svpetry/12VSupport/README.md

# 12VSupport
System to support a vehicle 12V electrical system with a LiIon battery to prevent the lead battery from depletion.
