svpetry/12VSupport/Board/12VSupport.kicad_pcb

## KiCad design Board/12VSupport.kicad_pcb (2026-06-07)

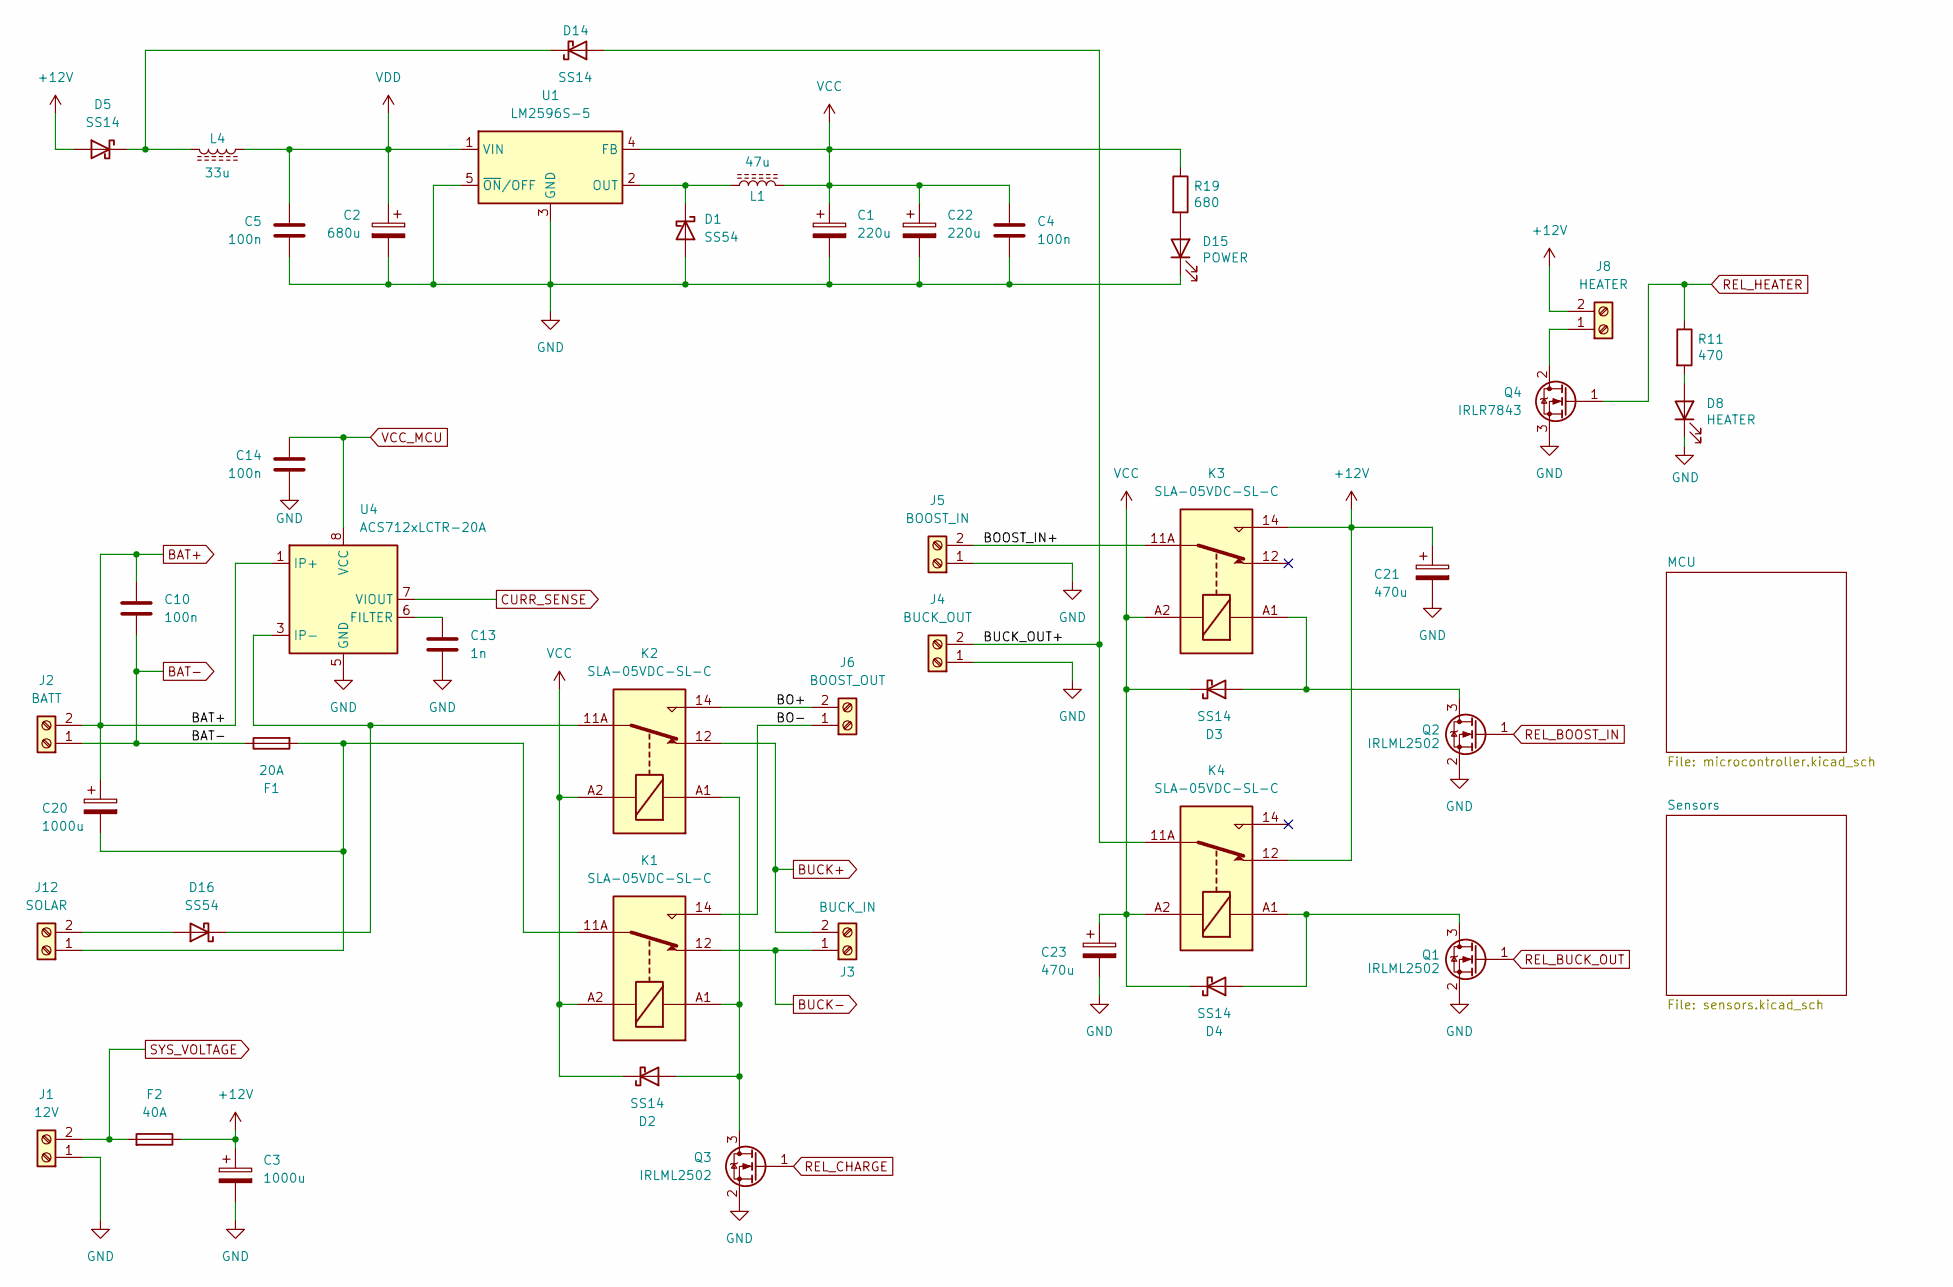
[picture p1: schematic 12VSupport.kicad_sch]

Parts:
C1, C22: 220u; CP_Radial_D6.3mm_P2.50mm
C2: 680u; CP_Radial_D10.0mm_P5.00mm
C3, C20: 1000u; CP_Radial_D13.0mm_P5.00mm
C4, C5, C10, C14: 100n; C_0805_2012Metric
C13: 1n; C_0805_2012Metric
C21: 470u; CP_Radial_D10.0mm_P5.00mm
C23: 470u; CP_Radial_D8.0mm_P3.80mm
D1, D16: SS54; D_SMB
D2, D3, D4, D5, D14: SS14; D_SMA
D8: HEATER; LED_0805_2012Metric
D15: POWER; LED_0805_2012Metric
F1: 20A; Fuseholder_Blade
F2: 40A; Fuseholder_Blade
J1: 12V; KF7.62_2P
J2: BATT; KF7.62_2P
J3: BUCK_IN; KF7.62_2P
J4: BUCK_OUT; KF7.62_2P
J5: BOOST_IN; KF7.62_2P
J6: BOOST_OUT; KF7.62_2P
J8: HEATER; TerminalBlock_Altech_AK300-2_P5.00mm
J12: SOLAR; TerminalBlock_Altech_AK300-2_P5.00mm
K1, K2, K3, K4: SLA-05VDC-SL-C; Relay_SPDT_RAYEX-L90
L1: 47u; L_12x12mm_H6mm
L4: 33u; L_10.4x10.4_H4.8
Q1, Q2, Q3: IRLML2502; SOT-23
Q4: IRLR7843; TO-252-2
R11: 470; R_0805_2012Metric
R19: 680; R_0805_2012Metric
U1: LM2596S-5; TO-263-5_TabPin3
U4: ACS712xLCTR-20A; SOIC-8_3.9x4.9mm_P1.27mm

Connections:
+12V: C3.1, C21.1, D5.2 (A), F2.1, J8.2, K3.14, K4.12
/BO+: J6.2, K2.14
/BO-: J6.1, K1.14
/BOOST_IN+: J5.2, K3.11A, K3.11B
/BUCK_OUT+: D14.2 (A), J4.2, K4.11A, K4.11B
BAT+: C10.1, C20.1, J2.2, U4.1 (IP+), U4.2 (IP+); also elsewhere on the board
BAT-: C10.2, F1.1, J2.1; also elsewhere on the board
BUCK+: J3.2, K2.12
BUCK-: J3.1, K1.12
CURR_SENSE: U4.7 (VIOUT); also elsewhere on the board
GND: C1.2, C2.2, C3.2, C4.2, C5.2, C13.2, C14.2, C21.2, C22.2, C23.2, D1.2 (A), D8.1 (K), D15.1 (K), J1.1, J4.1, J5.1, Q1.2 (S), Q2.2 (S), Q3.2 (S), Q4.3 (S), U1.3 (GND), U1.5 (~ON/OFF), U4.5 (GND); also elsewhere on the board
unnamed: D1.1 (K), L1.1, U1.2 (OUT)
unnamed: D2.2 (A), K1.A1, K2.A1, Q3.3 (D)
unnamed: D3.2 (A), K3.A1, Q2.3 (D)
unnamed: D4.2 (A), K4.A1, Q1.3 (D)
unnamed: D8.2 (A), R11.2
unnamed: D5.1 (K), D14.1 (K), L4.2
unnamed: D15.2 (A), R19.2
unnamed: D16.2 (A), J12.2
unnamed: D16.1 (K), K2.11A, K2.11B, U4.3 (IP-), U4.4 (IP-)
unnamed: J8.1, Q4.2 (D)
unnamed: C20.2, F1.2, J12.1, K1.11A, K1.11B
unnamed: C13.1, U4.6 (FILTER)
REL_BOOST_IN: Q2.1 (G); also elsewhere on the board
REL_BUCK_OUT: Q1.1 (G); also elsewhere on the board
REL_CHARGE: Q3.1 (G); also elsewhere on the board
REL_HEATER: Q4.1 (G), R11.1; also elsewhere on the board
SYS_VOLTAGE: F2.2, J1.2; also elsewhere on the board
VCC: C1.1, C4.1, C22.1, C23.1, D2.1 (K), D3.1 (K), D4.1 (K), K1.A2, K2.A2, K3.A2, K4.A2, L1.2, R19.1, U1.4 (FB); also elsewhere on the board
VCC_MCU: C14.1, U4.8 (VCC); also elsewhere on the board
VDD: C2.1, C5.1, L4.1, U1.1 (VIN); also elsewhere on the board

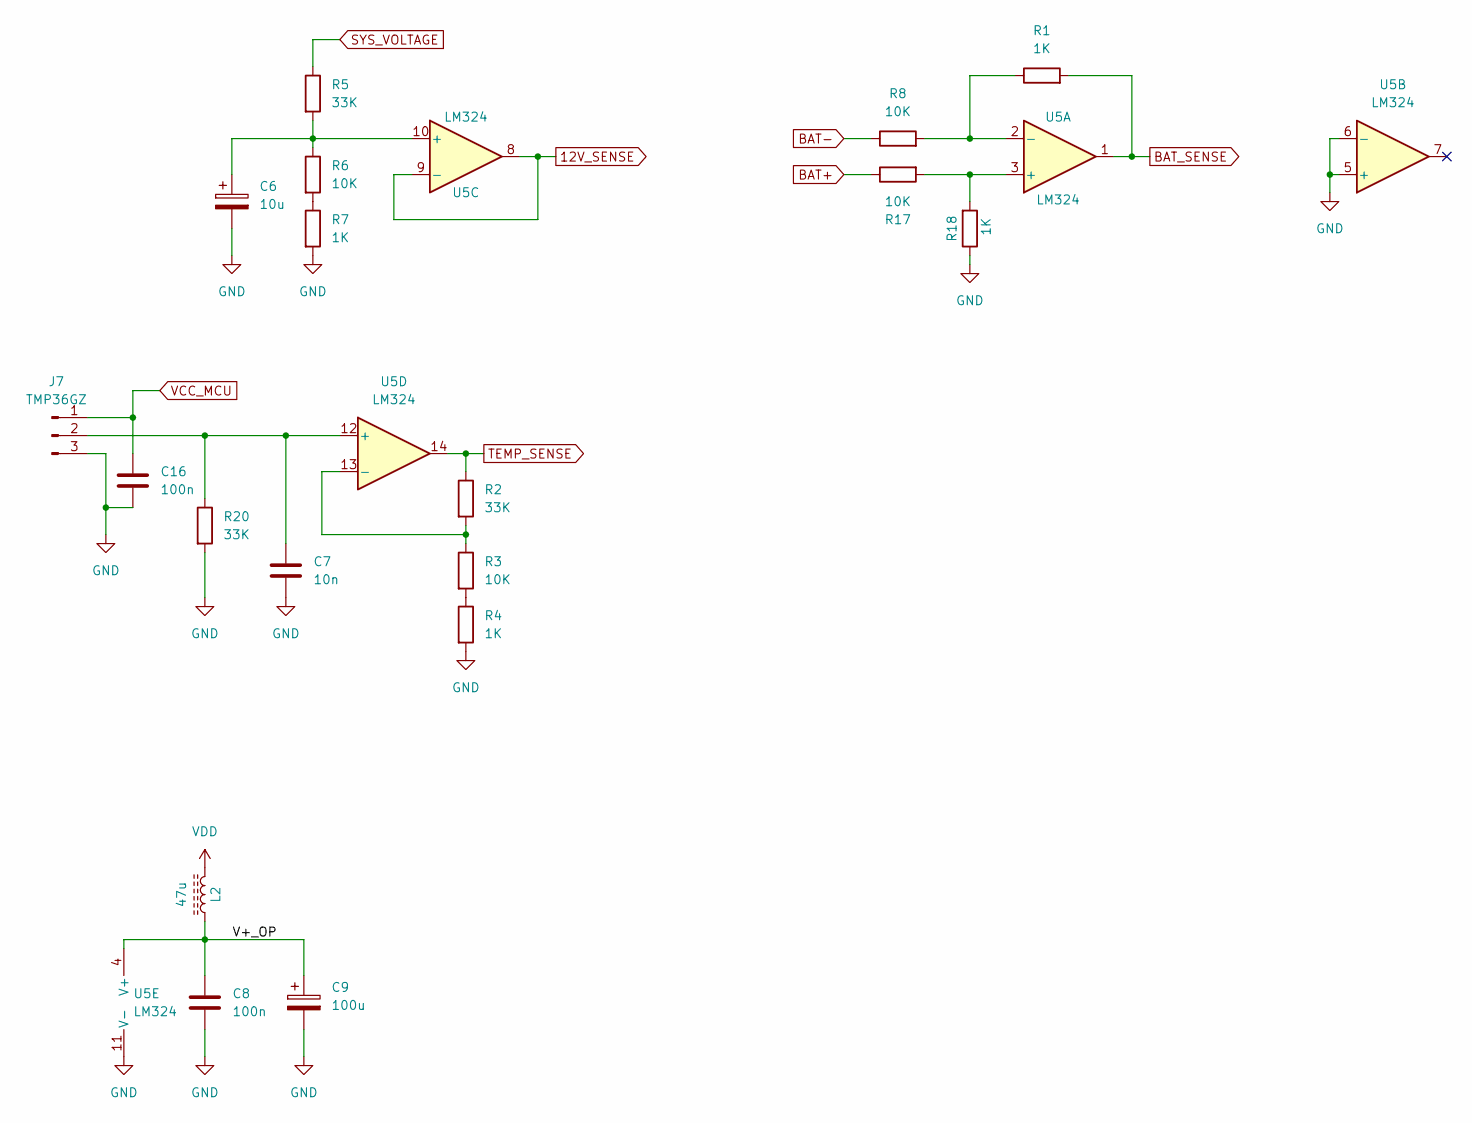
[picture p2: schematic sensors.kicad_sch]

Parts:
C6: 10u; C_1206_3216Metric_Pad1.33x1.80mm_HandSolder
C7: 10n; C_0805_2012Metric
C8, C16: 100n; C_0805_2012Metric
C9: 100u; CP_Radial_D5.0mm_P2.50mm
J7: TMP36GZ; JST_PH_B3B-PH-K_1x03_P2.00mm_Vertical
L2: 47u; L_10.4x10.4_H4.8
R1, R4, R7, R18: 1K; R_0805_2012Metric
R2, R5, R20: 33K; R_0805_2012Metric
R3, R6, R8, R17: 10K; R_0805_2012Metric
U5: LM324; SOIC-14_3.9x8.7mm_P1.27mm

Connections:
12V_SENSE: U5.8, U5.9 (-); also elsewhere on the board
/Sensors/V+_OP: C8.1, C9.1, L2.1, U5.4 (V+)
BAT+: R17.1; also elsewhere on the board
BAT-: R8.1; also elsewhere on the board
BAT_SENSE: R1.2, U5.1; also elsewhere on the board
GND: C6.2, C7.2, C8.2, C9.2, C16.2, J7.3, R4.2, R7.2, R18.1, R20.2, U5.5 (+), U5.6 (-), U5.11 (V-); also elsewhere on the board
unnamed: C7.1, J7.2, R20.1, U5.12 (+)
unnamed: R3.2, R4.1
unnamed: R6.2, R7.1
unnamed: R17.2, R18.2, U5.3 (+)
unnamed: R1.1, R8.2, U5.2 (-)
unnamed: C6.1, R5.2, R6.1, U5.10 (+)
unnamed: R2.2, R3.1, U5.13 (-)
SYS_VOLTAGE: R5.1; also elsewhere on the board
TEMP_SENSE: R2.1, U5.14; also elsewhere on the board
VCC_MCU: C16.1, J7.1; also elsewhere on the board
VDD: L2.2; also elsewhere on the board

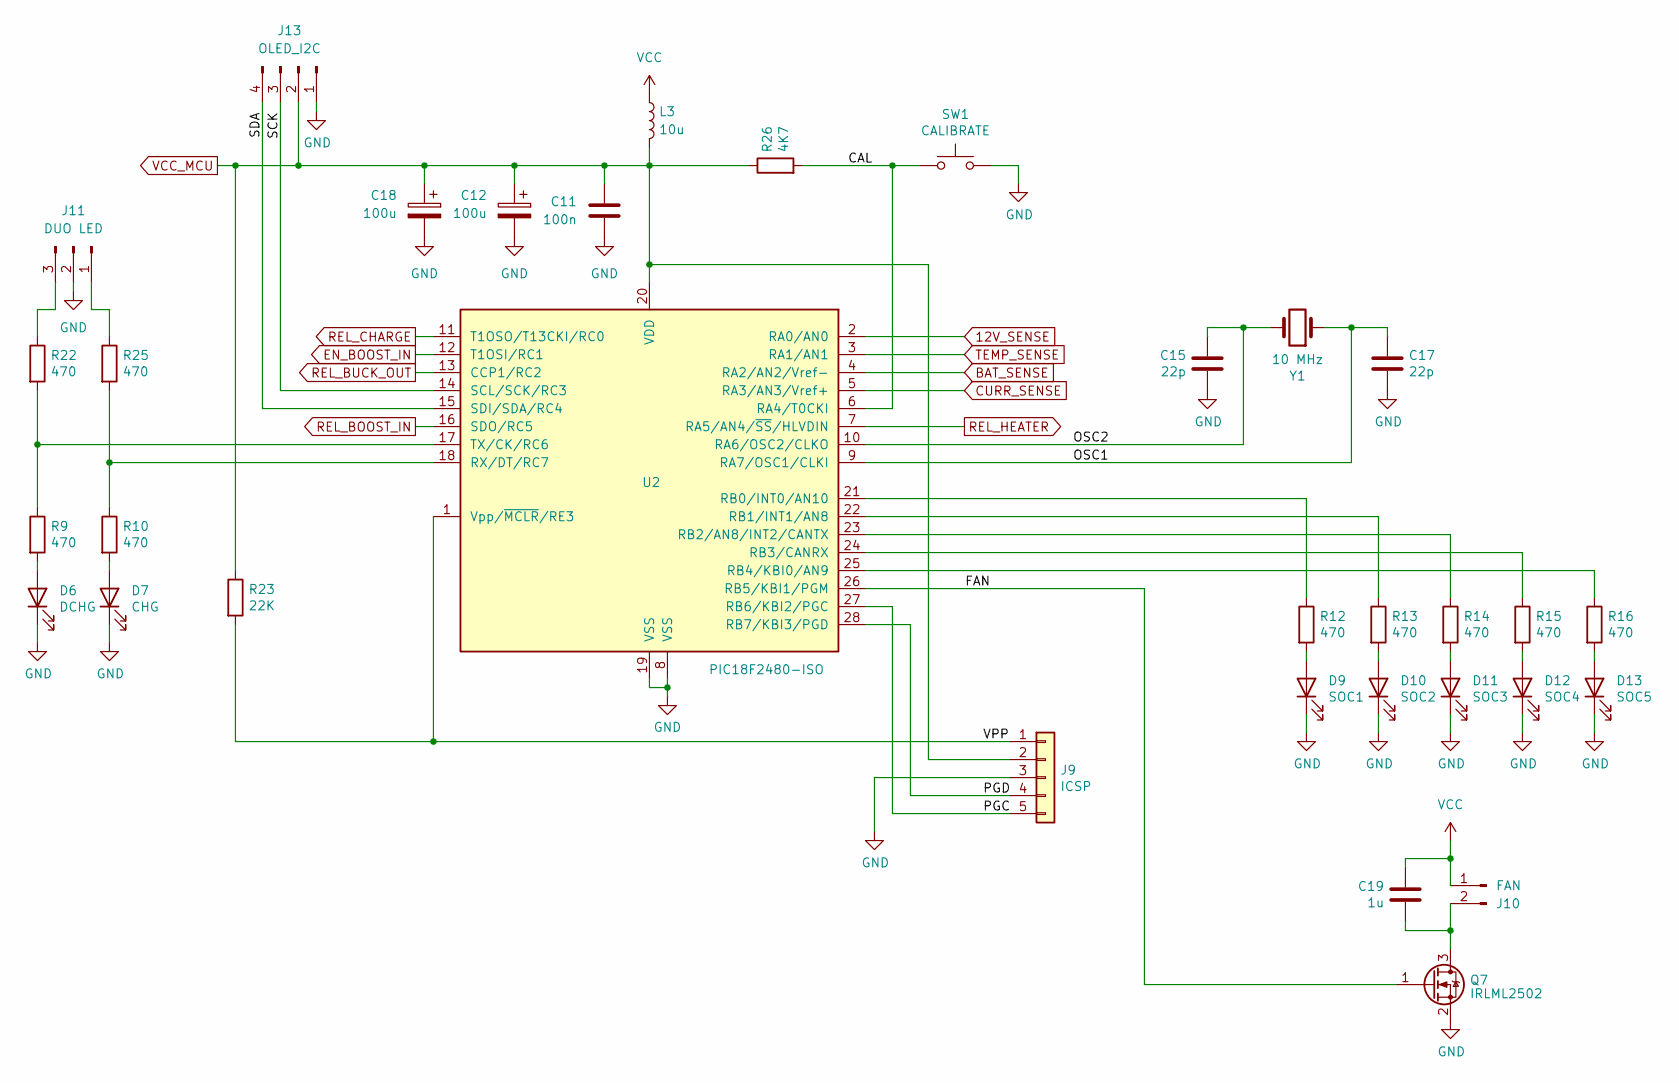
[picture p3: schematic microcontroller.kicad_sch]

Parts:
C11: 100n; C_0805_2012Metric
C12, C18: 100u; CP_Radial_D5.0mm_P2.50mm
C15, C17: 22p; C_0805_2012Metric
C19: 1u; C_1206_3216Metric
D6: DCHG; LED_0805_2012Metric
D7: CHG; LED_0805_2012Metric
D9: SOC1; LED_0805_2012Metric
D10: SOC2; LED_0805_2012Metric
D11: SOC3; LED_0805_2012Metric
D12: SOC4; LED_0805_2012Metric
D13: SOC5; LED_0805_2012Metric
J9: ICSP; PinHeader_1x05_P2.54mm_Vertical
J10: FAN; JST_XH_B2B-XH-A_1x02_P2.50mm_Vertical
J11: DUO LED; JST_PH_B3B-PH-K_1x03_P2.00mm_Vertical
J13: OLED_I2C; JST_PH_B4B-PH-K_1x04_P2.00mm_Vertical
L3: 10u; CD43
Q7: IRLML2502; SOT-23
R9, R10, R12, R13, R14, R15, R16, R22, R25: 470; R_0805_2012Metric
R23: 22K; R_0805_2012Metric
R26: 4K7; R_0805_2012Metric
SW1: CALIBRATE; SW_SPST_CK_RS282G05A3
U2: PIC18F2480-ISO; SOIC-28W_7.5x17.9mm_P1.27mm
Y1: 10 MHz; Crystal_HC18-U_Vertical

Connections:
12V_SENSE: U2.2 (RA0/AN0); also elsewhere on the board
/MCU/CAL: R26.2, SW1.1, U2.6 (RA4/T0CKI)
/MCU/FAN: Q7.1 (G), U2.26 (RB5/KBI1/PGM)
/MCU/OSC1: C17.1, U2.9 (RA7/OSC1/CLKI), Y1.1
/MCU/OSC2: C15.1, U2.10 (RA6/OSC2/CLKO), Y1.2
/MCU/PGC: J9.5, U2.27 (RB6/KBI2/PGC)
/MCU/PGD: J9.4, U2.28 (RB7/KBI3/PGD)
/MCU/SCK: J13.3, U2.14 (SCL/SCK/RC3)
/MCU/SDA: J13.4, U2.15 (SDI/SDA/RC4)
/MCU/VPP: J9.1, R23.2, U2.1 (Vpp/~MCLR/RE3)
BAT_SENSE: U2.4 (RA2/AN2/Vref-); also elsewhere on the board
CURR_SENSE: U2.5 (RA3/AN3/Vref+); also elsewhere on the board
EN_BOOST_IN: U2.12 (T1OSI/RC1)
GND: C11.2, C12.2, C15.2, C17.2, C18.2, D6.1 (K), D7.1 (K), D9.1 (K), D10.1 (K), D11.1 (K), D12.1 (K), D13.1 (K), J9.3, J11.2, J13.1, Q7.2 (S), SW1.2, U2.8 (VSS), U2.19 (VSS); also elsewhere on the board
unnamed: D6.2 (A), R9.2
unnamed: D7.2 (A), R10.2
unnamed: D9.2 (A), R12.2
unnamed: D10.2 (A), R13.2
unnamed: D11.2 (A), R14.2
unnamed: D12.2 (A), R15.2
unnamed: D13.2 (A), R16.2
unnamed: C19.2, J10.2, Q7.3 (D)
unnamed: J11.1, R25.1
unnamed: J11.3, R22.1
unnamed: R12.1, U2.21 (RB0/INT0/AN10)
unnamed: R13.1, U2.22 (RB1/INT1/AN8)
unnamed: R14.1, U2.23 (RB2/AN8/INT2/CANTX)
unnamed: R15.1, U2.24 (RB3/CANRX)
unnamed: R16.1, U2.25 (RB4/KBI0/AN9)
unnamed: R10.1, R25.2, U2.18 (RX/DT/RC7)
unnamed: R9.1, R22.2, U2.17 (TX/CK/RC6)
REL_BOOST_IN: U2.16 (SDO/RC5); also elsewhere on the board
REL_BUCK_OUT: U2.13 (CCP1/RC2); also elsewhere on the board
REL_CHARGE: U2.11 (T1OSO/T13CKI/RC0); also elsewhere on the board
REL_HEATER: U2.7 (RA5/AN4/~SS/HLVDIN); also elsewhere on the board
TEMP_SENSE: U2.3 (RA1/AN1); also elsewhere on the board
VCC: C19.1, J10.1, L3.1; also elsewhere on the board
VCC_MCU: C11.1, C12.1, C18.1, J9.2, J13.2, L3.2, R23.1, R26.1, U2.20 (VDD); also elsewhere on the board

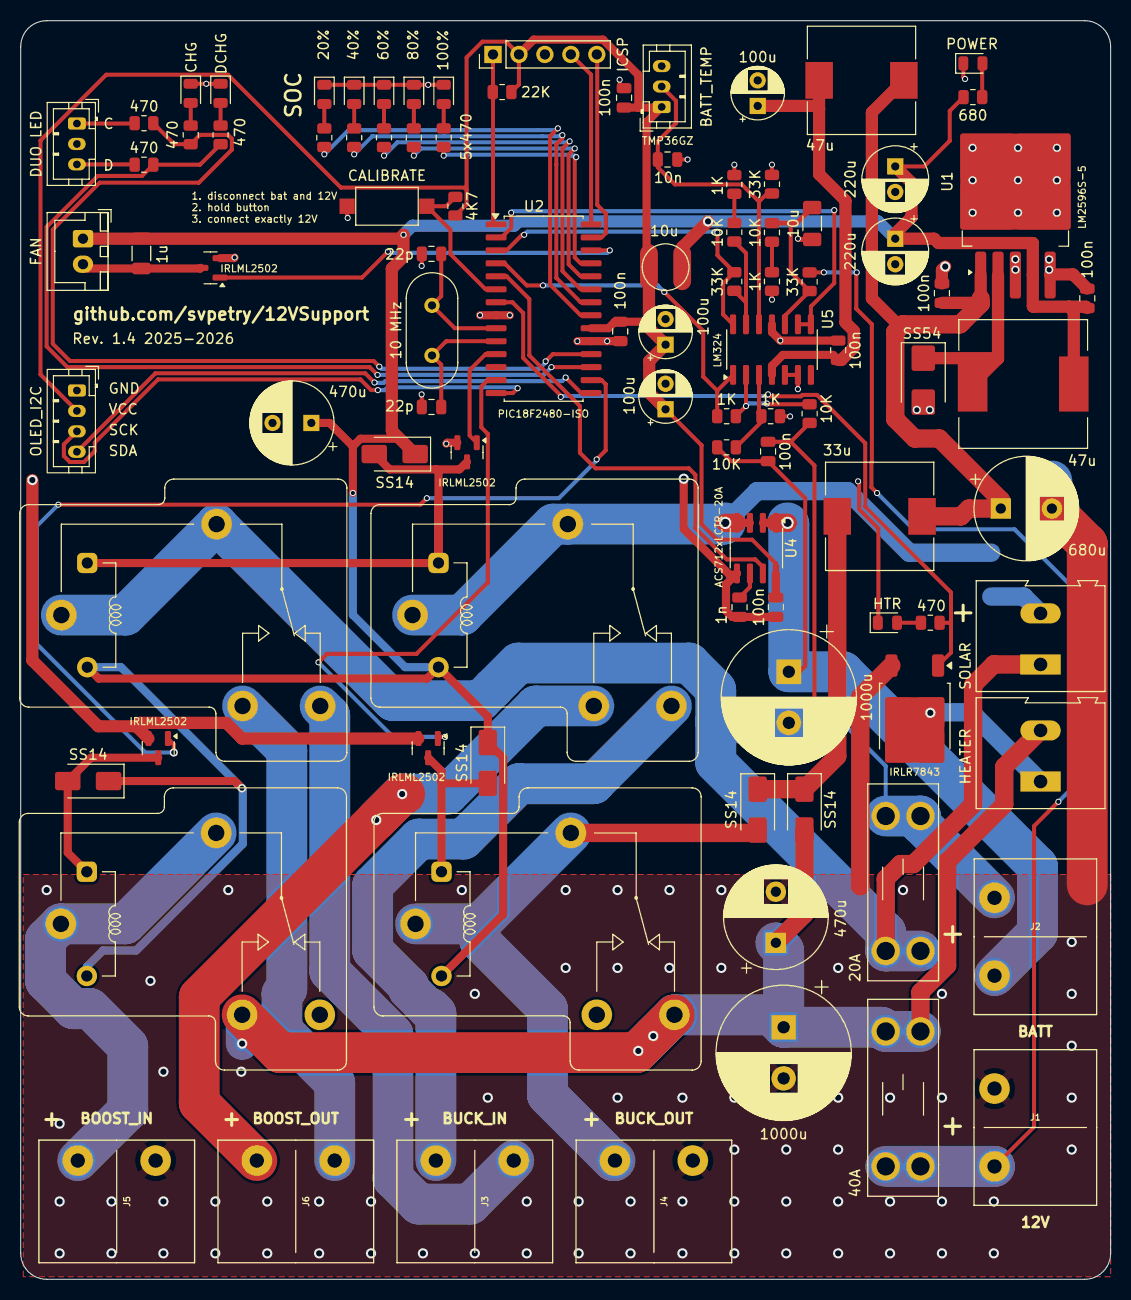
[picture p4: board 12VSupport.kicad_pcb from above]

Board: 2 copper layers, 106.7 x 123.2 mm, 97 parts (1 on the bottom side), 68 nets.
