svpetry/12VSupport/MCU/sensors.c

#include <xc.h>
#include "sensors.h"
#include "eeprom.h"
#include "constants.h"
#include "base.h"

// sensor values
long system_voltage_mem[SENSOR_MEM_COUNT]; // system voltage in mV
long system_voltage; // system voltage in mV

long batt_voltage_mem[SENSOR_MEM_COUNT]; // battery voltage in mV
long batt_voltage; // battery voltage in mV

int batt_temp_mem[SENSOR_MEM_COUNT]; // battery temperature in 1/10 deg C
int batt_temp; // battery temperature in 1/10 deg C

long batt_current_mem[SENSOR_MEM_COUNT]; // battery current in mA
long batt_current; // battery current in mA
long batt_current_abs; // abs battery current in mA

long correction = 0;
long amp_correction = 0;

uint16_t ADC_Read(uint8_t channel) {
    if (channel > 13) return 0;  // Invalid channel check
    
    ADCON0 &= 0b11000001;        // Clear channel selection bits
    ADCON0 |= (channel << 2);    // Set the required channel
    __delay_us(50);              // Acquisition time to charge hold capacitor
    
    ADCON0bits.GO = 1;           // Start A/D conversion
    while (ADCON0bits.GO);       // Wait for conversion to complete
   
    return (uint16_t)((ADRESH << 8) + ADRESL);  // Return 10-bit result
}

long ReadMillivolts(uint8_t channel) {
    long value = 0;
    for (uint8_t i = 0; i < 5; i++) {
        value += ADC_Read(channel);
        __delay_ms(4);
    }
    return (value * 1000) / 1024 + correction;
}

void ReadBattCurrent() {
    for (uint8_t i = SENSOR_MEM_COUNT - 1; i > 0; i--)
        batt_current_mem[i] = batt_current_mem[i - 1];

    // 100 mV/A
    batt_current_mem[0] = (ReadMillivolts(3) - 2500) * 10 + amp_correction;
    
    batt_current = 0;
    for (uint8_t i = 0; i < SENSOR_MEM_COUNT; i++)
        batt_current += batt_current_mem[i];
    batt_current /= SENSOR_MEM_COUNT;
    
    if (batt_current < 0)
        batt_current_abs = -batt_current;
    else
        batt_current_abs = batt_current;
}

void ReadSensors() {
    for (uint8_t i = SENSOR_MEM_COUNT - 1; i > 0; i--) {
        system_voltage_mem[i] = system_voltage_mem[i - 1];
        batt_voltage_mem[i] = batt_voltage_mem[i - 1];
        batt_temp_mem[i] = batt_temp_mem[i - 1];
    }
    
    // voltage is divided by 4
    system_voltage_mem[0] = ReadMillivolts(0) * 4;
    
    // 10 mV/degC, 500 mV = 0 degC, multiplied with 4
    batt_temp_mem[0] = (int)((ReadMillivolts(1) - 4 * 500) / 4);
    
    // voltage is divided by 10
    batt_voltage_mem[0] = ReadMillivolts(2) * 10;

    system_voltage = 0;
    batt_temp = 0;
    batt_voltage = 0;
    for (uint8_t i = 0; i < SENSOR_MEM_COUNT; i++) {
        system_voltage += system_voltage_mem[i];
        batt_temp += batt_temp_mem[i];
        batt_voltage += batt_voltage_mem[i];
    }
    system_voltage /= SENSOR_MEM_COUNT;
    batt_temp /= SENSOR_MEM_COUNT;
    batt_voltage /= SENSOR_MEM_COUNT;
    
    ReadBattCurrent();
}

void InitSensors() {
    correction = EEPROM_Read_32Bit(EEPROM_ADDR_CORRECTION_FACTOR);
    amp_correction = EEPROM_Read_32Bit(EEPROM_ADDR_AMP_CORRECTION_FACTOR);
}

void Calibrate() {
    // requires exactly 12V on the supply line
    correction = 0;
    amp_correction = 0;

    correction = 3000 - ReadMillivolts(0);

    ReadBattCurrent();
    amp_correction = -batt_current_mem[0];
    
    EEPROM_Write_32Bit(EEPROM_ADDR_CORRECTION_FACTOR, correction);
    EEPROM_Write_32Bit(EEPROM_ADDR_AMP_CORRECTION_FACTOR, amp_correction);
}
