svpetry/12VSupport/(commit log)

2024-11-30 Rename VPP signal
    [microcontroller.kicad_sch]
2024-11-30 Change fuse holders.
    [12VSupport.kicad_pcb, 12VSupport.kicad_sch]
2024-12-01 Fixes current sensor
    [12VSupport.kicad_pcb, sensors.kicad_sch]
2024-12-01 Detect missing battery.
2024-12-01 Remove diode in MCU supply line so MCU has full 5V.
    [12VSupport.kicad_pcb, 12VSupport.kicad_sch, microcontroller.kicad_sch]
2024-12-02 Added ground plane.
    [12VSupport.kicad_pcb]
2024-12-08 MCU: Save calculated full capacity to EEPROM.
2024-12-08 Board WIP
    [12VSupport.kicad_pcb, 12VSupport.kicad_sch, microcontroller.kicad_sch, sensors.kicad_sch]
2024-12-11 Rev 1.0
    [12VSupport-B_Cu.gbl, 12VSupport-B_Mask.gbs, 12VSupport-B_Paste.gbp, 12VSupport-B_Silkscreen.gbo, 12VSupport-Edge_Cuts.gm1, 12VSupport-F_Cu.gtl, 12VSupport-F_Mask.gts, 12VSupport-F_Paste.gtp]
2024-12-14 Layout improvements. Set version to 1.1
    [12VSupport.kicad_pcb, 12VSupport.kicad_sch, microcontroller.kicad_sch, sensors.kicad_sch]
2024-12-20 Fixes AD read bug.
    [main.c, sensors.c]
2024-12-21 Schematic fixes
    [12VSupport.kicad_pcb, 12VSupport.kicad_sch, sensors.kicad_sch]
2024-12-21 Fixes temperature calculation
2024-12-21 Fixes battery voltage sensing.
    [12VSupport.kicad_pcb, 12VSupport.kicad_sch, sensors.kicad_sch]
2024-12-31 Schematic/layout improvements.
    [12VSupport.kicad_pcb, 12VSupport.kicad_sch]
2024-12-31 1.1 improvements
    [12VSupport.kicad_pcb, 12VSupport.kicad_sch, microcontroller.kicad_sch, sensors.kicad_sch]
2025-01-05 Minor improvements
    [12VSupport.kicad_pcb, 12VSupport.kicad_sch]
2025-01-05 Larger screw terminals.
    [12VSupport.kicad_pcb, 12VSupport.kicad_sch]
2025-01-05 Update date
    [12VSupport.kicad_pcb, 12VSupport.kicad_sch, microcontroller.kicad_sch, sensors.kicad_sch]
2025-01-05 Rev. 1.1
    [12VSupport-B_Cu.gbl, 12VSupport-B_Mask.gbs, 12VSupport-B_Paste.gbp, 12VSupport-B_Silkscreen.gbo, 12VSupport-Edge_Cuts.gm1, 12VSupport-F_Cu.gtl, 12VSupport-F_Mask.gts, 12VSupport-F_Paste.gtp]
2025-01-11 Silkscreen fix
    [12VSupport.kicad_pcb, 12VSupport.kicad_sch]
2025-01-12 Add constants for LiIon 10s battery.
2025-01-12 LiFePO4 capacity 40AH
2025-01-12 Bugfix in capacity calculation
    [capacity.c, constants.h]
2025-01-25 Set version number to 1.2. Various fixes. Add fan connector.
    [12VSupport.kicad_pcb, 12VSupport.kicad_sch, microcontroller.kicad_sch, sensors.kicad_sch]
2025-01-25 Adds connector for external duo LED
    [12VSupport.kicad_pcb, microcontroller.kicad_sch]
2025-01-26 Changed battery temp sensor connector.
    [12VSupport.kicad_pcb, sensors.kicad_sch]
2025-01-29 Change fan connector.
    [12VSupport.kicad_pcb, microcontroller.kicad_sch]
2025-02-08 New layout
    [12VSupport.kicad_pcb, 12VSupport.kicad_sch, microcontroller.kicad_sch, sensors.kicad_sch]
2025-02-08 Minor layout changes
    [12VSupport.kicad_pcb]
2025-02-08 Rev. 1.2
    [12VSupport-B_Cu.gbl, 12VSupport-B_Mask.gbs, 12VSupport-B_Paste.gbp, 12VSupport-B_Silkscreen.gbo, 12VSupport-Edge_Cuts.gm1, 12VSupport-F_Cu.gtl, 12VSupport-F_Mask.gts, 12VSupport-F_Paste.gtp]
2025-02-08 Remove boost converter input MOSFET
2025-02-22 Fix calibration.
2025-03-02 Kicad 9.0
    [12VSupport.kicad_sch, microcontroller.kicad_sch, sensors.kicad_sch]
2025-03-02 Fixes fan. Sets max battery temp to 50 degC.
    [constants.h, main.c]
2025-03-03 Bugfixes. Highest SOC led is now blinking when charging.
    [constants.h, main.c]
2025-03-06 Fixes SOC led bug.
    [main.c]
2025-03-06 Workaround for relais problems.
    [main.c]
2025-03-07 Kicad 9.0 migration
    [12VSupport.kicad_pcb]
2025-04-17 Bugfixes. Improvements
    [12VSupport.kicad_pcb, 12VSupport.kicad_sch, microcontroller.kicad_sch, sensors.kicad_sch]
2025-06-04 Changes voltage levels
2025-06-14 Replace unsigned char with uint8_t
    [eeprom.c, main.c, sensors.c]
2026-06-06 Saved with new KiCad version.
2026-06-07 - REL_HEATER is now RA5 (was RC3) - REL_BOOST_IN is now RC5 (was RC4) Add I2C OLED display connector Add AGENTS.md
    [12VSupport.kicad_pcb, 12VSupport.kicad_sch, microcontroller.kicad_sch]
2026-06-07 Add OLED battery status display
2026-06-07 Show CALIBRATING on display
2026-06-07 Bump version to 1.4
    [12VSupport.kicad_pcb, 12VSupport.kicad_sch, microcontroller.kicad_sch, sensors.kicad_sch]
2026-06-16 Rewrite AGENTS.md
    Condense agent guidance into focused sections: units/math, build,
    interrupt-driven runtime gotchas, calibration, chemistry switch,
    and file list.
2026-06-18 Board: Small schematic layout changes
    [12VSupport.kicad_sch, sensors.kicad_sch]
2026-06-18 Add battery temperature to OLed display
